vanvught/EXT-PHY-RTL8201F-RTL8305NB-2xHR871181A/README.md

# External PHY RTL8201F with switch RTL8305NB and 2xHR871181A

More information [https://www.gd32-dmx.org/ethernet.html](https://www.gd32-dmx.org/ethernet.html)
