vanvught/EXT-PHY-RTL8201F-RTL8305NB-2xHR871181A/BOM.xlsx

Qty | Designator | Footprint | Comment | LCSC Part # | Original
7 | C1, C9, C10, C20, C22, C26, C29 | A/3216-18R | 10uF | C7171
29 | C2, C3, C4, C5, C6, C7, C8, C11, C12, C13, C14, C15, C16, C17, C18, C19, C21, C23, C24, C25, C27, C30, C31, C32, C33, C34, C35, C36, C37 | C0402 | 100n | C1525
1 | C28 | C0603 | 10uF | C19702
2 | C38, C39 | C1206 | 1nF/2kV | C9196
7 | FL1, FL2, FL3, FL4, FL5, FL6, FL7 | 603 | MZAS1608G121-1R3TF | C709642
1 | IC1 | QFN40P600X600X100-49N | RTL8305NB-CG | C3010343
1 | IC2 | QFN50P500X500X100-33N | RTL8201F-VB-CG | C45044
2 | J1, J2 | HR871181A | HR871181A | C49312
1 | LED1 | CHIP-LED0603 | PWR | C72043
1 | LED2 | CHIP-LED0603 | STATUSP0 | C72043
1 | LED3 | CHIP-LED0603 | ACTIVE | C72043
1 | LED4 | CHIP-LED0603 | LINK | C72043
1 | Q1 | 3.2X2.5_KXO-V96 | 50MHz | C160451
1 | Q2 | 3.2X2.5_KXO-V96 | 25MHz | C295525 | C160454
3 | R1, R4, R13 | R0603 | 1K5 | C22843
1 | R11 | R0603 | 0R | C115304
2 | R14, R17 | R0603 | 2K49 | C100897
6 | R2, R3, R7, R10, R15, R16 | R0603 | 4K7 | C23162
5 | R5, R6, R8, R9, R12 | R0603 | 510 | C23193
1 | RN1 | 4X0402ARV341 | 3.3 | C728736
2 | RN2, RN3 | 4X0402ARV341 | 33 | C25501
