vanvught/EXT-PHY-RTL8201F-RTL8305NB-2xHR871181A/EXT-PHY.pdf

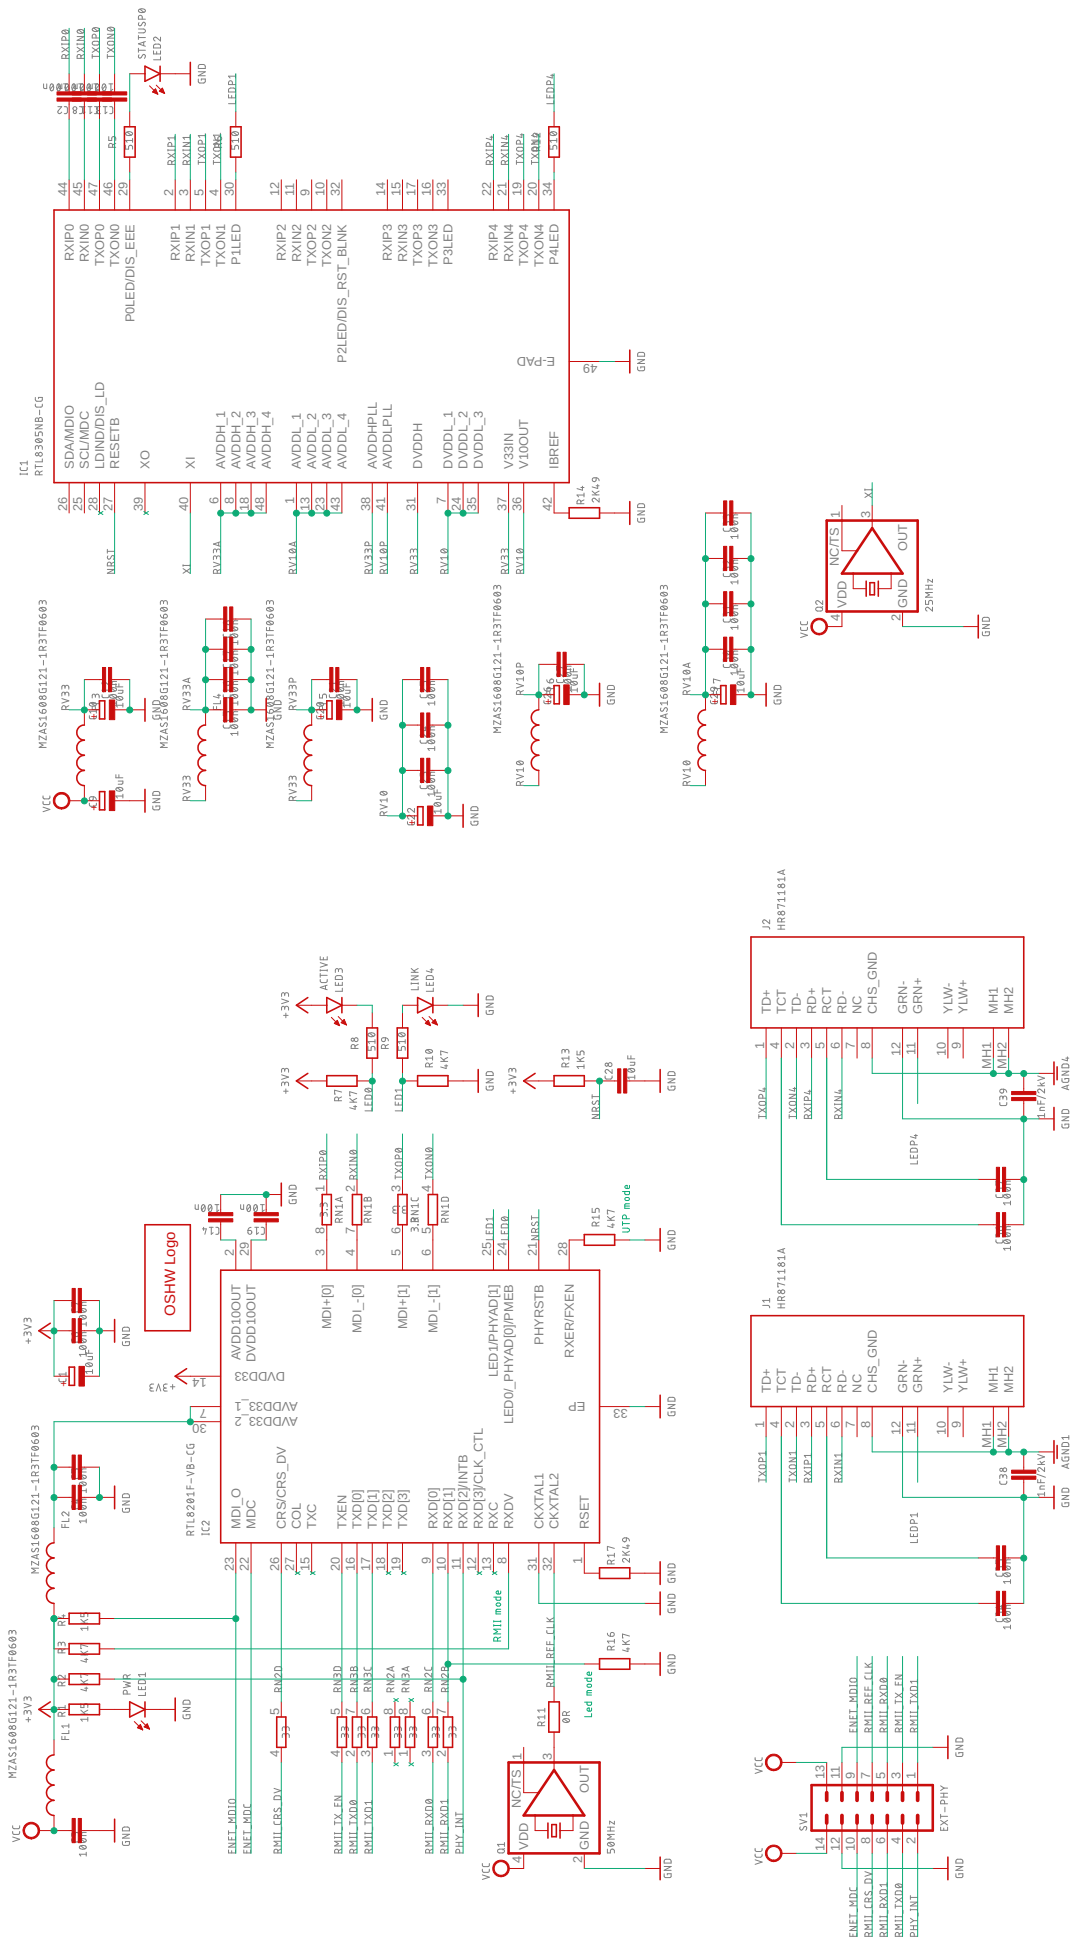
[picture p1: page 1]

8 RXD[0] 9 RXD[1] 10 RXD[2]/INTB
