vanvught/EXT-PHY-RTL8201F-RTL8305NB-2xHR871181A/EXT-PHY.brd

## EAGLE design EXT-PHY.brd (2024-03-03)

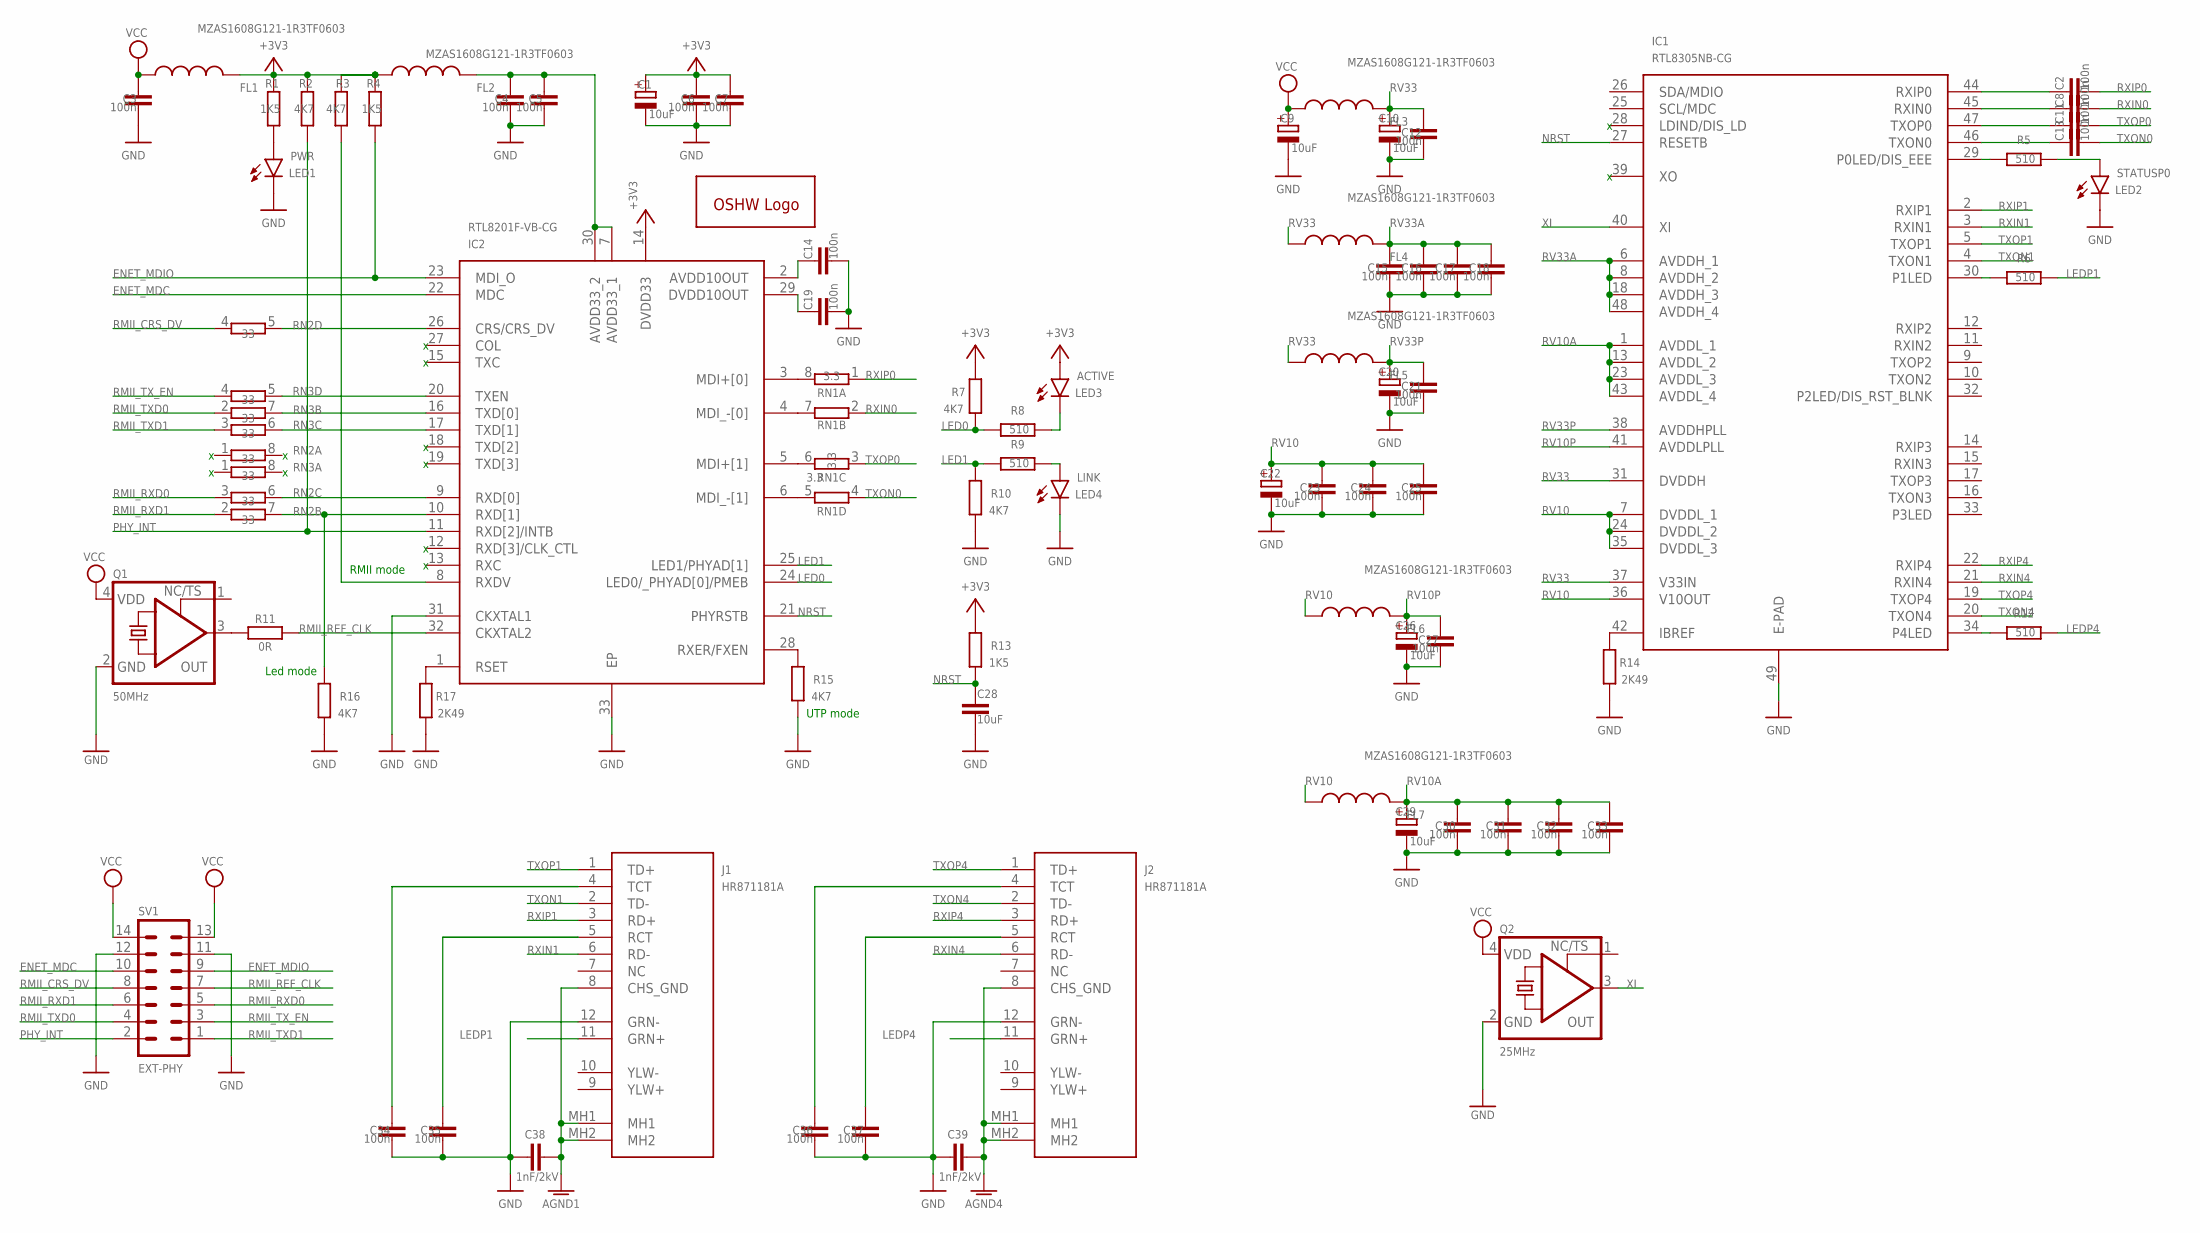
[picture p2: schematic EXT-PHY.sch]

Parts:
C1, C9, C10, C20, C22, C26, C29: 10uF; A/3216-18R; JLCPCB C7171
C2, C3, C4, C5, C6, C7, C8, C11, C12, C13, C14, C15, C16, C17, C18, C19, C21, C23, C24, C25, C27, C30, C31, C32, C33, C34, C35, C36, C37: 100n; C0402; JLCPCB C1525
C28: 10uF; C0603; JLCPCB C19702
C38, C39: 1nF/2kV; C1206; JLCPCB C9196
FL1, FL2, FL3, FL4, FL5, FL6, FL7: MZAS1608G121-1R3TF0603; 0603
GOLD_ORB_SM1: OSHWLOGOLOGO5MM; OSHW_5MM
IC1: RTL8305NB-CG; QFN40P600X600X100-49N
IC2: RTL8201F-VB-CG; QFN50P500X500X100-33N; JLCPCB C45044
J1, J2: HR871181A
LED1: PWR; CHIP-LED0603; JLCPCB C72043
LED2: STATUSP0; CHIP-LED0603; JLCPCB C72043
LED3: ACTIVE; CHIP-LED0603; JLCPCB C72043
LED4: LINK; CHIP-LED0603; JLCPCB C72043
Q1: 50MHz; 3.2X2.5_KXO-V96; JLCPCB C160451
Q2: 25MHz; 3.2X2.5_KXO-V96; JLCPCB C160454
R1, R4, R13: 1K5; R0603; JLCPCB C22843
R2, R3, R7, R10, R15, R16: 4K7; R0603; JLCPCB C23162
R5, R6, R8, R9, R12: 510; R0603; JLCPCB C23193
R11: 0R; R0603; JLCPCB C115304
R14, R17: 2K49; R0603; JLCPCB C100897
RN1: 3.3; 4X0402ARV341; JLCPCB C728736
RN2, RN3: 33; 4X0402ARV341; JLCPCB C25501
SV1: EXT-PHY; MA07-2W

Connections:
50MHZ: Q1.3 (OUT), R11.1
+3V3: C1.+, C6.2, C7.2, FL1.2, FL2.1, IC2.14 (DVDD33), LED3.A, R1.2, R2.2, R3.1, R4.2, R7.2, R13.2
AGND1: C38.2, J1.8 (CHS_GND), J1.MH1, J1.MH2
AGND4: C39.2, J2.8 (CHS_GND), J2.MH1, J2.MH2
AVDD: C4.2, C5.2, FL2.2, IC2.7 (AVDD33_1), IC2.30 (AVDD33_2)
ENET_MDC: IC2.22 (MDC), SV1.10
ENET_MDIO: IC2.23 (MDI_O), R4.1, SV1.9
GND: C1.-, C3.1, C4.1, C5.1, C6.1, C7.1, C9.-, C10.-, C12.1, C14.2, C15.1, C16.1, C17.1, C18.1, C19.2, C20.-, C21.1, C22.-, C23.1, C24.1, C25.1, C26.-, C27.1, C28.2, C29.-, C30.1, C31.1, C32.1, C33.1, C34.1, C35.1, C36.1, C37.1, C38.1, C39.1, IC1.49 (E-PAD), IC2.31 (CKXTAL1), IC2.33 (EP), J1.12 (GRN-), J2.12 (GRN-), LED1.C, LED2.C, LED4.C, Q1.2 (GND), Q2.2 (GND), R10.1, R14.2, R15.1, R16.1, R17.2, SV1.11, SV1.12
LED0: IC2.24 (LED0/_PHYAD[0]/PMEB), R7.1, R8.2
LED1: IC2.25 (LED1/PHYAD[1]), R9.2, R10.2
LEDP1: J1.11 (GRN+), R6.1
LEDP4: J2.11 (GRN+), R12.1
unnamed: LED1.A, R1.1
unnamed: C37.2, J2.5 (RCT)
unnamed: C36.2, J2.4 (TCT)
unnamed: IC2.1 (RSET), R17.1
unnamed: IC2.8 (RXDV), R3.2
unnamed: C14.1, IC2.2 (AVDD10OUT)
unnamed: IC2.28 (RXER/FXEN), R15.2
unnamed: IC1.42 (IBREF), R14.1
unnamed: C35.2, J1.5 (RCT)
unnamed: C34.2, J1.4 (TCT)
unnamed: C19.1, IC2.29 (DVDD10OUT)
unnamed: IC1.30 (P1LED), R6.2
unnamed: IC1.34 (P4LED), R12.2
unnamed: IC2.3 (MDI+[0]), RN1.8 (2)
unnamed: LED3.C, R8.1
unnamed: IC2.4 (MDI_-[0]), RN1.7 (2)
unnamed: IC2.5 (MDI+[1]), RN1.6 (2)
unnamed: IC2.6 (MDI_-[1]), RN1.5 (2)
unnamed: LED2.A, R5.1
unnamed: IC1.29 (P0LED/DIS_EEE), R5.2
unnamed: C13.1, IC1.46 (TXON0)
unnamed: C11.1, IC1.47 (TXOP0)
unnamed: C8.1, IC1.45 (RXIN0)
unnamed: C2.1, IC1.44 (RXIP0)
unnamed: LED4.A, R9.1
NRST: C28.1, IC1.27 (RESETB), IC2.21 (PHYRSTB), R13.1
PHY_INT: IC2.11 (RXD[2]/INTB), R2.1, SV1.2
RMII_CRS_DV: RN2.4 (1), SV1.8
RMII_REF_CLK: IC2.32 (CKXTAL2), R11.2, SV1.7
RMII_RXD0: RN2.3 (1), SV1.5
RMII_RXD1: RN2.2 (1), SV1.6
RMII_TXD0: RN3.2 (1), SV1.4
RMII_TXD1: RN3.3 (1), SV1.1
RMII_TX_EN: RN3.4 (1), SV1.3
RV10: C22.+, C23.2, C24.2, C25.2, FL6.1, FL7.1, IC1.7 (DVDDL_1), IC1.24 (DVDDL_2), IC1.35 (DVDDL_3), IC1.36 (V10OUT)
RV10A: C29.+, C30.2, C31.2, C32.2, C33.2, FL7.2, IC1.1 (AVDDL_1), IC1.13 (AVDDL_2), IC1.23 (AVDDL_3), IC1.43 (AVDDL_4)
RV10P: C26.+, C27.2, FL6.2, IC1.41 (AVDDLPLL)
RV33: C10.+, C12.2, FL3.2, FL4.1, FL5.1, IC1.31 (DVDDH), IC1.37 (V33IN)
RV33A: C15.2, C16.2, C17.2, C18.2, FL4.2, IC1.6 (AVDDH_1), IC1.8 (AVDDH_2), IC1.18 (AVDDH_3), IC1.48 (AVDDH_4)
RV33P: C20.+, C21.2, FL5.2, IC1.38 (AVDDHPLL)
RXD0: IC2.9 (RXD[0]), RN2.6 (2)
RXD1: IC2.10 (RXD[1]), R16.2, RN2.7 (2)
RXDV: IC2.26 (CRS/CRS_DV), RN2.5 (2)
RXIN0: C8.2, RN1.2 (1)
RXIN1: IC1.3 (RXIN1), J1.6 (RD-)
RXIN4: IC1.21 (RXIN4), J2.6 (RD-)
RXIP0: C2.2, RN1.1
RXIP1: IC1.2 (RXIP1), J1.3 (RD+)
RXIP4: IC1.22 (RXIP4), J2.3 (RD+)
TXD0: IC2.16 (TXD[0]), RN3.7 (2)
TXD1: IC2.17 (TXD[1]), RN3.6 (2)
TXEN: IC2.20 (TXEN), RN3.5 (2)
TXON0: C13.2, RN1.4 (1)
TXON1: IC1.4 (TXON1), J1.2 (TD-)
TXON4: IC1.20 (TXON4), J2.2 (TD-)
TXOP0: C11.2, RN1.3 (1)
TXOP1: IC1.5 (TXOP1), J1.1 (TD+)
TXOP4: IC1.19 (TXOP4), J2.1 (TD+)
VCC: C3.2, C9.+, FL1.1, FL3.1, Q1.4 (VDD), Q2.4 (VDD), SV1.13, SV1.14
XI: IC1.40 (XI), Q2.3 (OUT)

Notes on the sheet:
RMII mode
UTP mode
Led mode

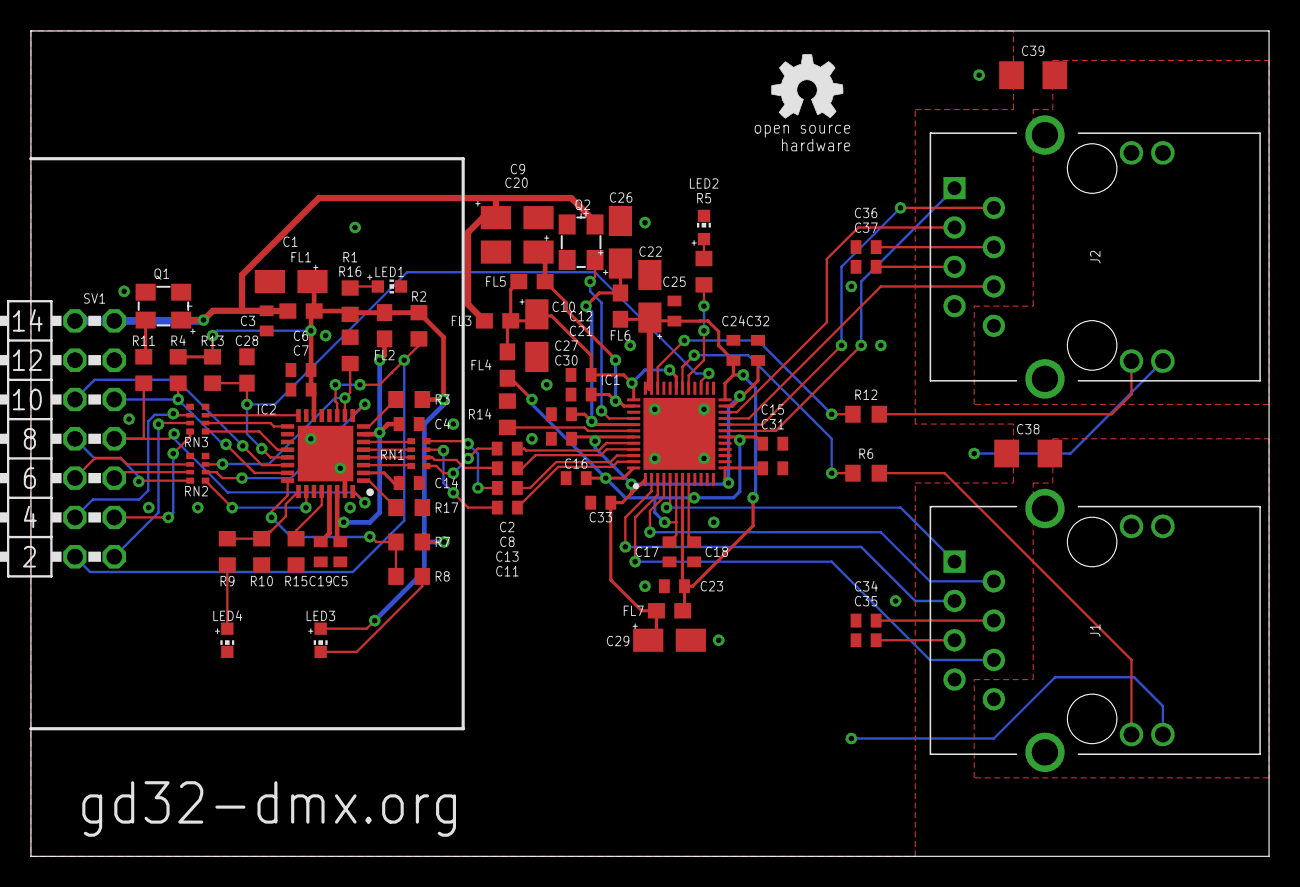
[picture p3: board EXT-PHY.brd from above]

Board: 2 copper layers, 80.0 x 53.3 mm, 78 parts (0 on the bottom side), 72 nets.
