vanvught/EXT-PHY-RTL8201F-RTL8305NB-2xHR871181A/(notices)

Notices in the files:
parts and their libraries:
crystal-geyer_V1_0: Copyright: Geyer-Electronic
